josepablovr/Cable-Cam/docs/Assembly_Instructions.pdf

## Omar Gabriel Fuentes Aguilar Victor Vargas Chacon

## Juan Pablo Jimenez Anderson

Adrian Ernesto Orozco Rivera | 2017158313
| 2018099431
| 2018131797
| 2015158616
Jose Pablo Vasquez Rojas | 2019204801

## MT-8003 Manufacturing Systems

# Students:

Professor: Eng. Jaime Mora Meléndez M.Sc.

# Academic Area of Mechatronic Engineering

# Final Project: Assembly Instructions

# I Semester

2022

Machine Translated by Google

Second part of the framework

Ultrasonic sensor

Toothed pulley | 5
| 4

Assembly process:

4

Center pulley

Final assembly

1

6

5

1

Camera support | 2

Cabinet

7

Bearing support | 2
Support pulleys | 3

Parts List

Spreader bars | 3

First, the ultrasonic sensor support is assembled, 2 screws are used.

### M3x12 and its nuts. The same operation is repeated on the other part of the same

### M3x6, washers and nuts. Then the axle support is placed with 3 screws

### It should be assembled as follows:

## 1. Ultrasonic sensor

Assembly process:

### Index of instructions and sections

structure.

### 4 M3x12 screws with their respective nuts must be used. This process must be repeated in

### 3. Camera support

### Now the camera support is going to be assembled, for this 2 screws are used

### Bearing support

the other of the frame plates.

### Next, the bearing support is assembled, in this case they must

2.

M3x70, with washers and nuts and the 1¼-inch screw.
Note: The screw head is inserted all the way into the printed support.

### greater rigidity. To do this, use 4 M3x70 screws with their respective nuts and

### 5. Support pulleys

### Now the support pulleys will be placed, these use sleeves as

### The spreader bars are then placed on the structure, these provide it

washers.

### 4. Spreader bars

### spacers, use 2 of these sleeves, the pulley, 1 bearing and a steel shaft for

this part of the assembly. This step is repeated on the other side of the structure.

Center pulley

of plastic welding between the pulley and the shaft notches for optimal performance.

To mount the central pulley, the remaining 2 sleeves, the pulley and the shaft are used.

6.

Note: When attaching the pulley, an epoxy resin glue or glue must be used.

### 7. Second part of the frame Next, the

second part of the frame is assembled.

nut that must be inserted into the pulley slot.

9.

The last step is to place the electronic part cabinet. To do this use the 4

M3x20 screws, together with the spacers and nuts as shown in the figure.

In this step you will place the toothed pulley, for this use an M3x12 screw and a

Cabinet

### 8. Toothed pulley

This is what the final assembly should look like.

### After this step the engine must be placed, the 20T-2GT toothed pulley together with its

### 10. Final assembly

timing band.

## Parts List
