josepablovr/Cable-Cam/docs/wiring_diagram.pdf

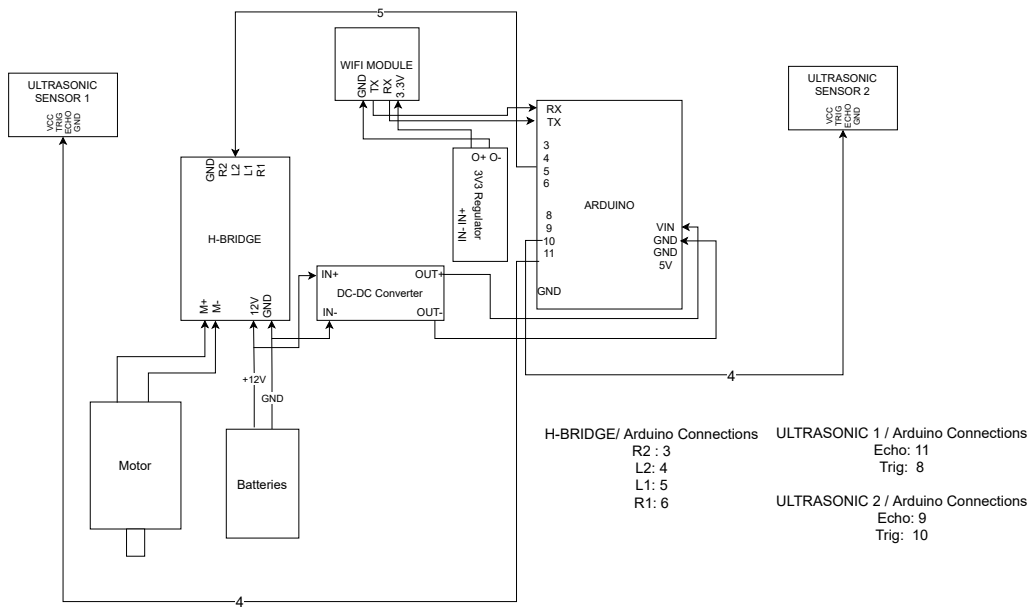
[picture p4: page 1]
H-BRIDGE; GND; OUT+; OUT-; ARDUINO; VIN GND GND 5V; ULTRASONIC; Batteries; Motor; Echo: 11 Trig: 8; Echo: 9 Trig: 10

WIFI MODULE GND TXRX 3.3V

SENSOR 1 VCC TRIG ECHO GND

SENSOR 2 VCC TRIG ECHO GND

3V3 Regulator IN- IN+

DC-DC Converter

H-BRIDGE/ Arduino Connections

ULTRASONIC 1 / Arduino Connections

ULTRASONIC 2 / Arduino Connections
