josepablovr/Cable-Cam/docs/Blueprints.pdf

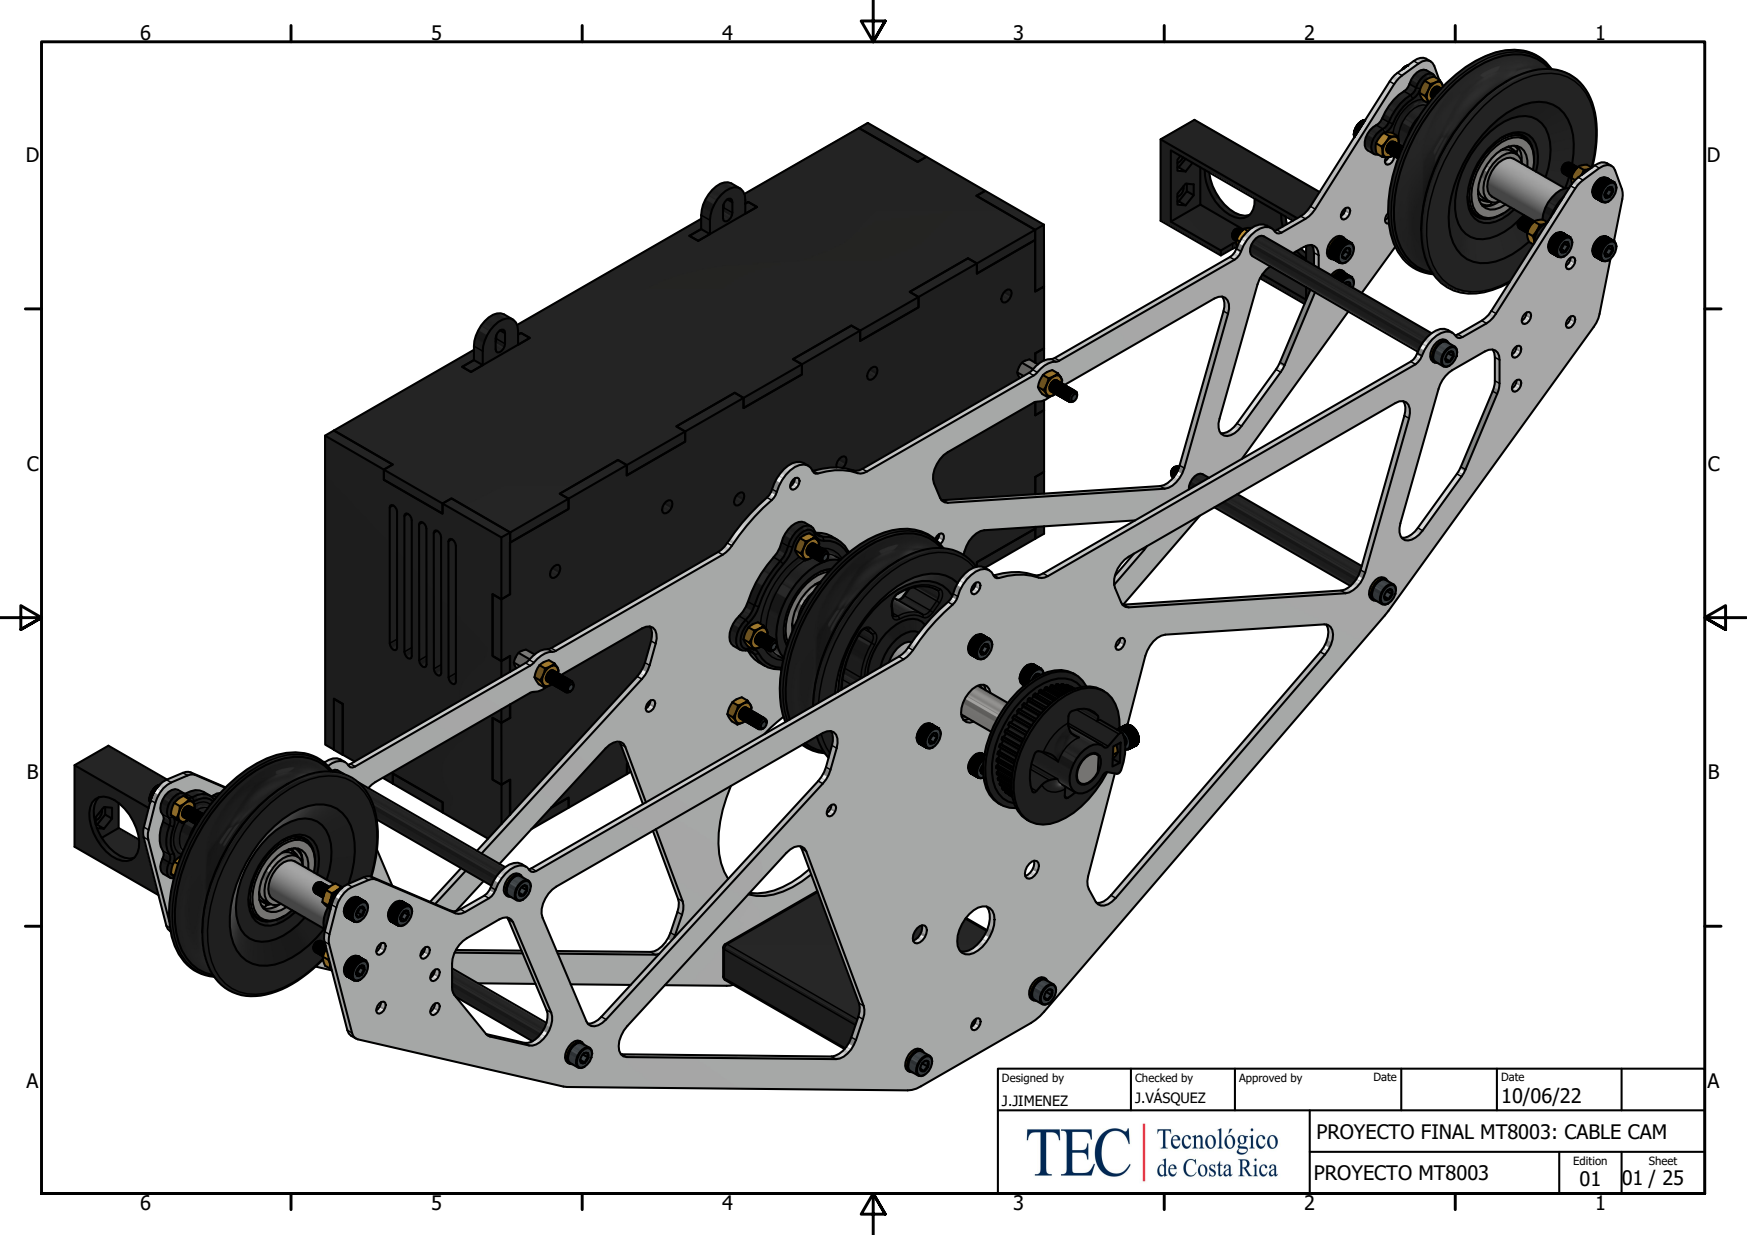
[picture p5: page 1]
PROYECTO MT8003; J.JIMENEZ; J.VÈSQUEZ; Designed by; Checked by; Approved by; Date; Edition; Sheet

PROYECTO FINAL MT8003: CABLE CAM

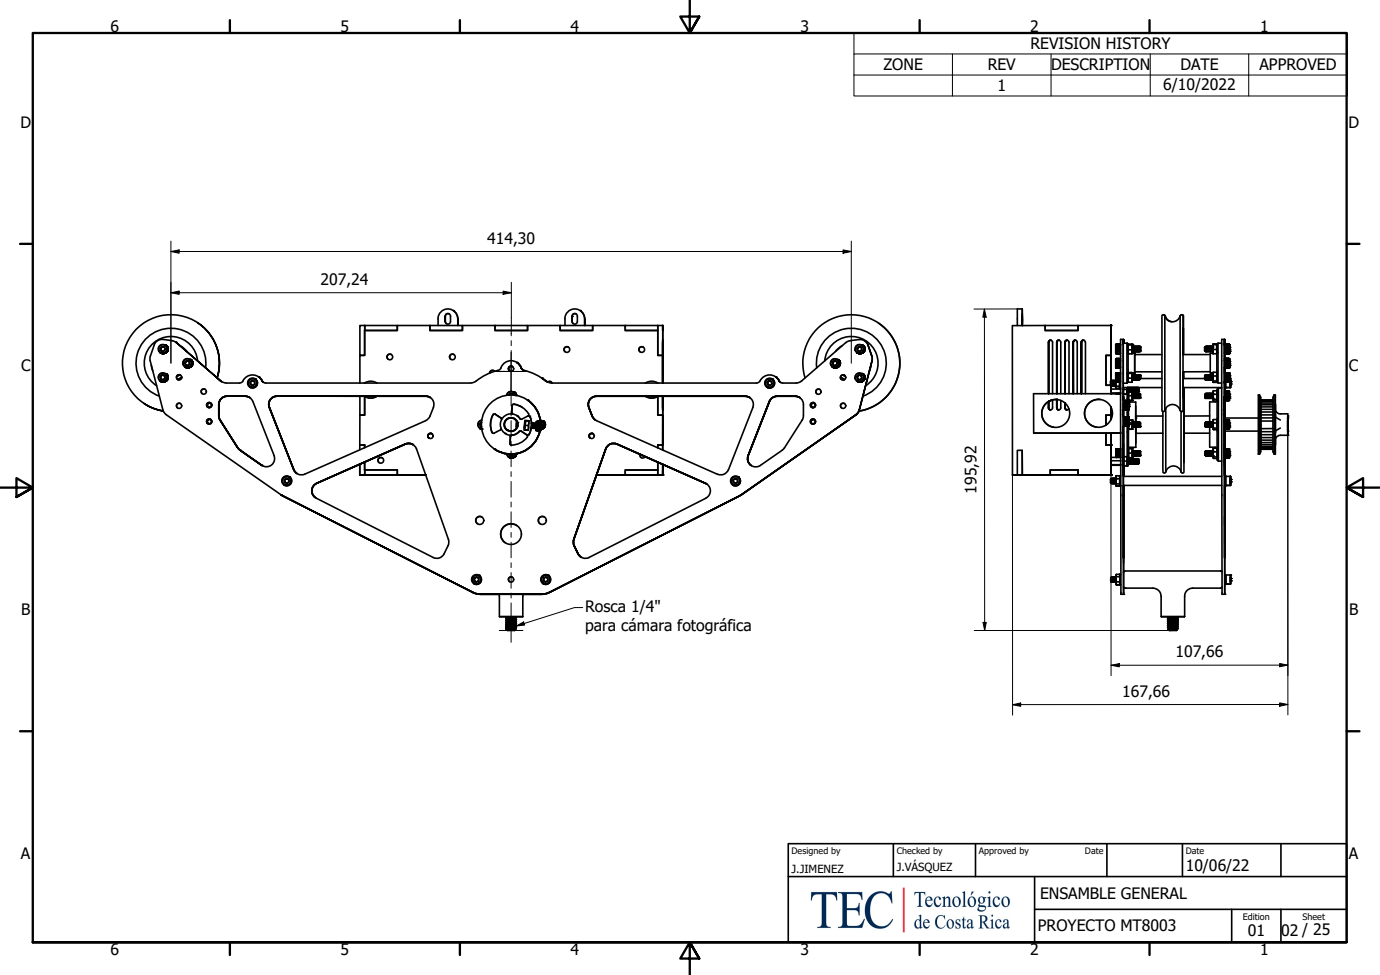
[picture p6: page 2]
J.JIMENEZ; J.VÈSQUEZ; Designed by; Checked by; Approved by; Date; REVISION HISTORY; ZONE; REV; DESCRIPTION; DATE; APPROVED; ENSAMBLE GENERAL

Rosca 1/4"
para cimara fotogrifica

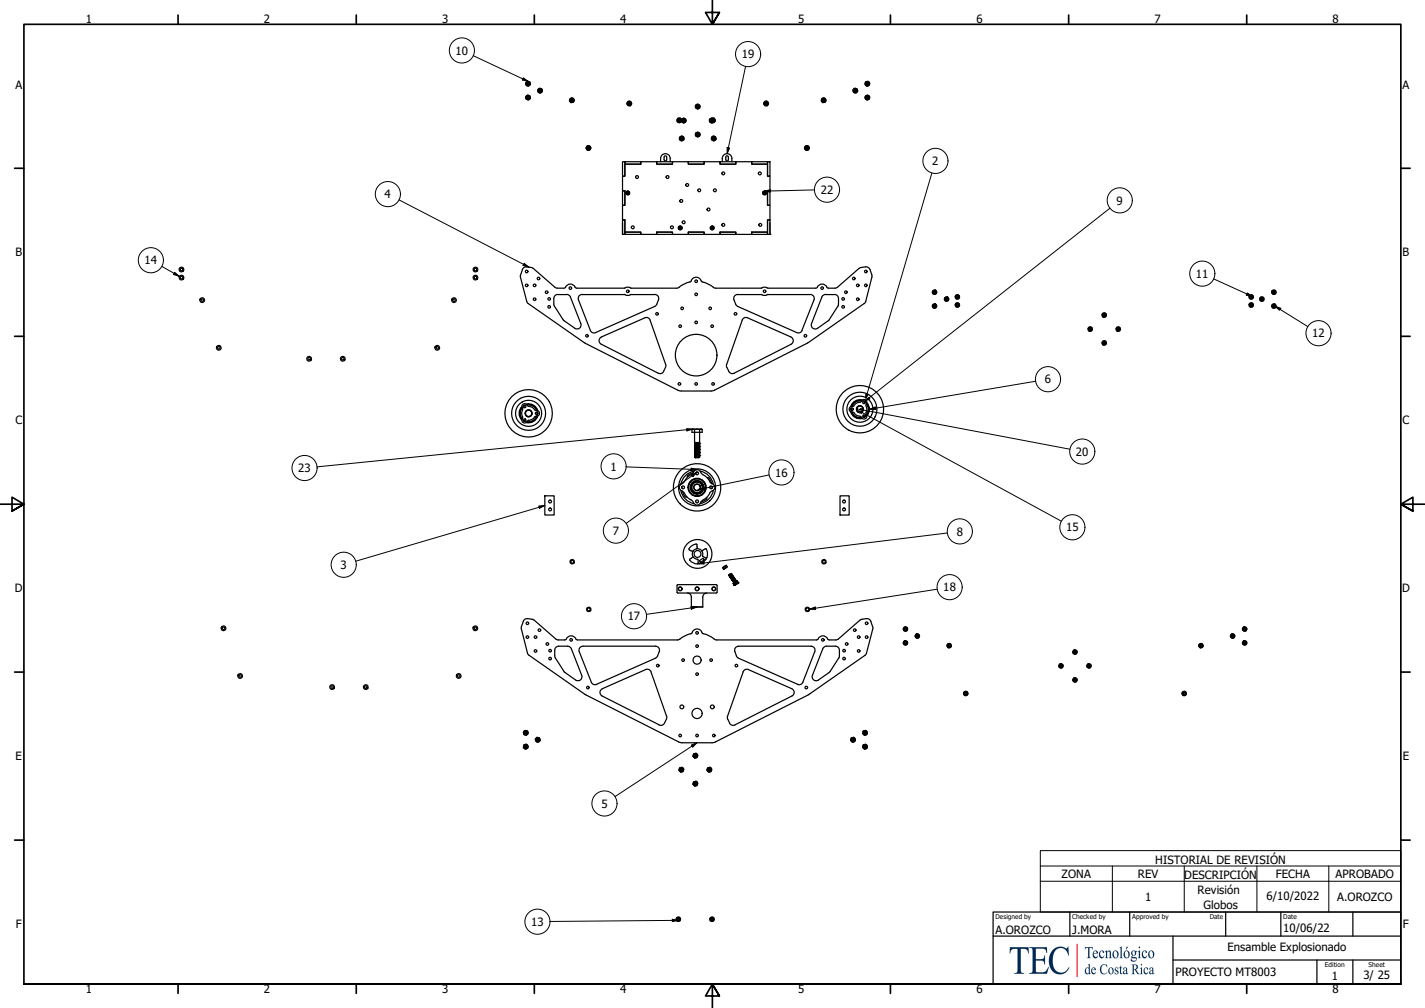
[picture p7: page 3]
Ensamble Explosionado; A.OROZCO; J.MORA; Designed by; Checked by; Approved by; Date; ZONA; REV; DESCRIPCIÓN; FECHA; APROBADO; Revisión Globos

HISTORIAL DE REVISIÓN

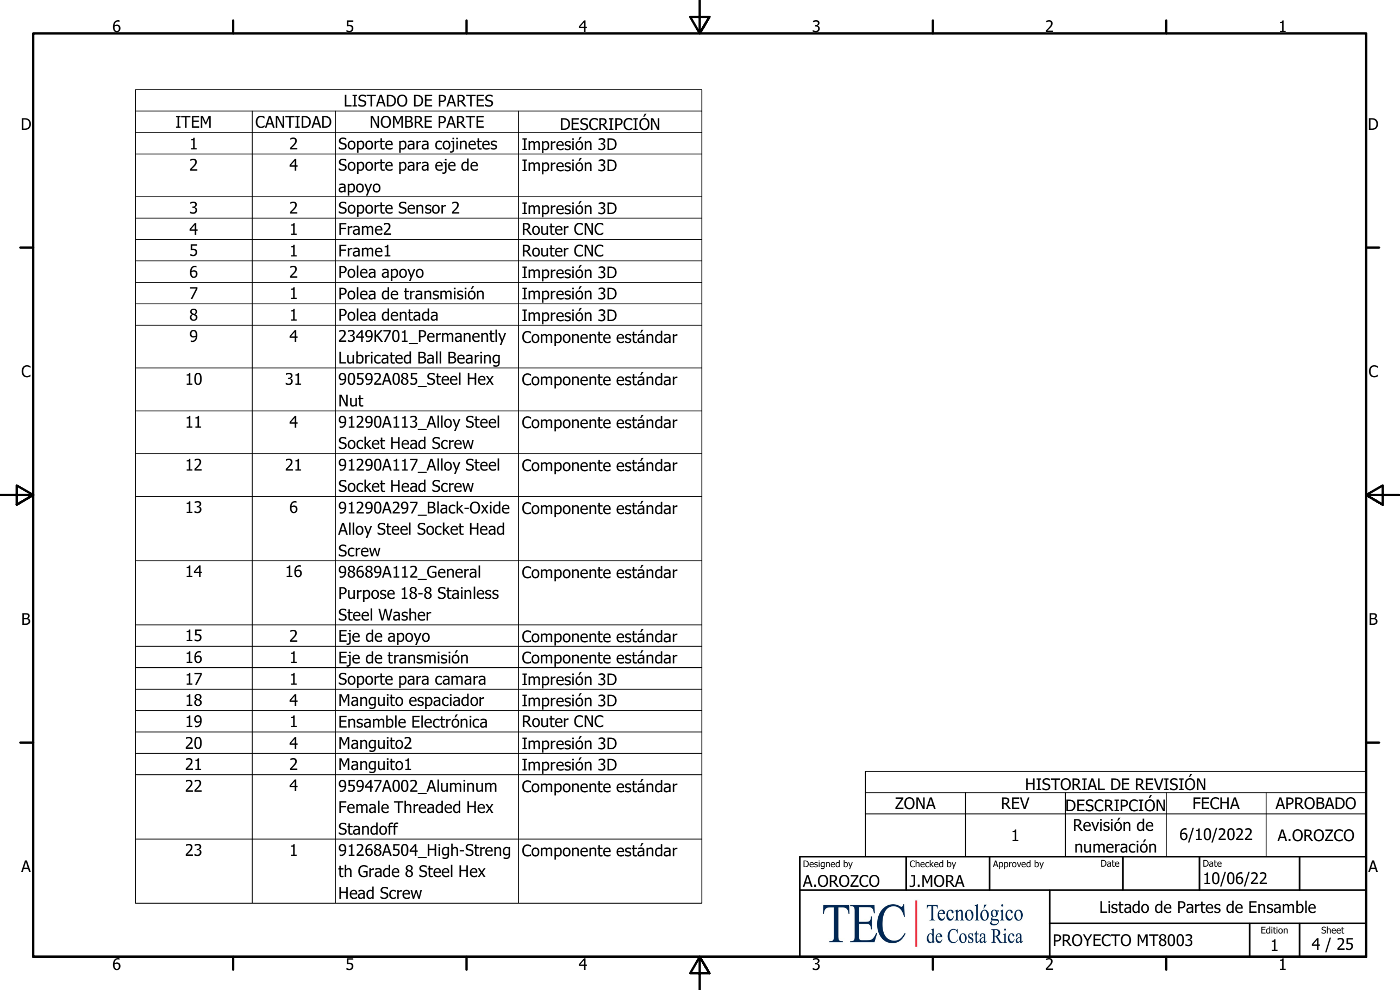
[picture p8: figure]
ole; tly; all B; _Allo; Bla; Allo; nle; ble; Ele; _Alu; ale
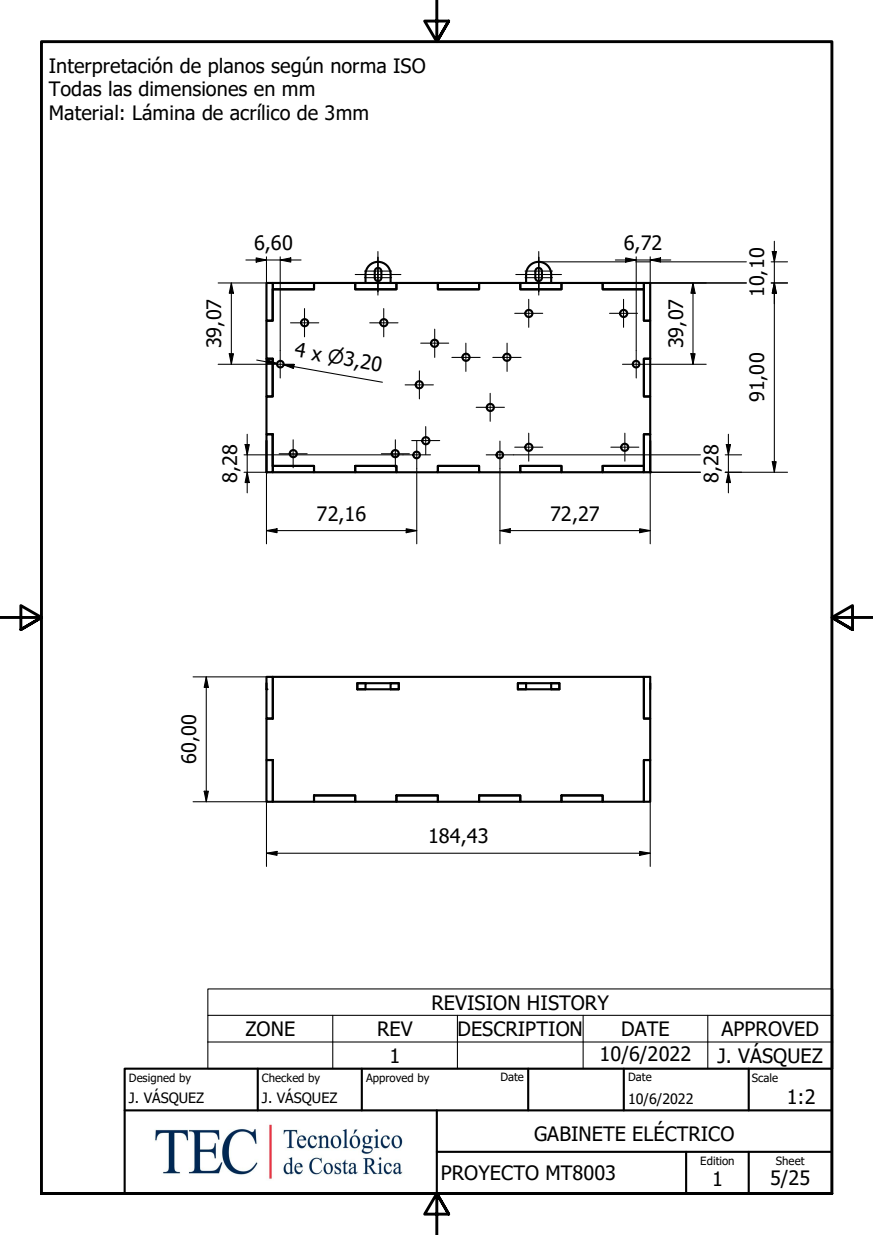
[picture p9: page 5]
GABINETE ELeCTRICO; J. VÈSQUEZ; Designed by; Checked by; Approved by; Date; Scale; REVISION HISTORY; ZONE; REV; DESCRIPTION; DATE; APPROVED

Interpretaciyn de planos seg~n norma ISO
Todas las dimensiones en mm
Material: Limina de acrtlico de 3mm

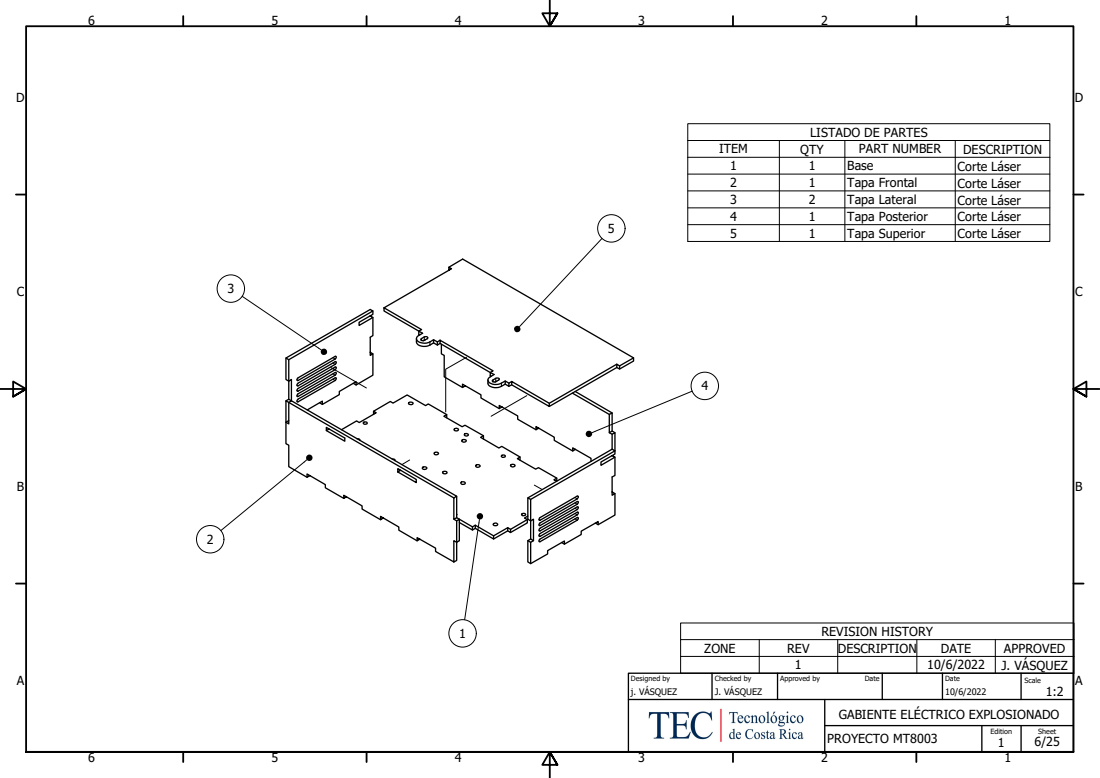
[picture p10: page 6]
ITEM; QTY; PART NUMBER; DESCRIPTION; Base; Corte Liser; Tapa Frontal; Tapa Lateral; Tapa Posterior; Tapa Superior; j. VÈSQUEZ; J. VÈSQUEZ; Designed by; Checked by; Approved by; Date; Scale; REVISION HISTORY; ZONE; REV; DATE; APPROVED

LISTADO DE PARTES

GABIENTE ELeCTRICO EXPLOSIONADO

A

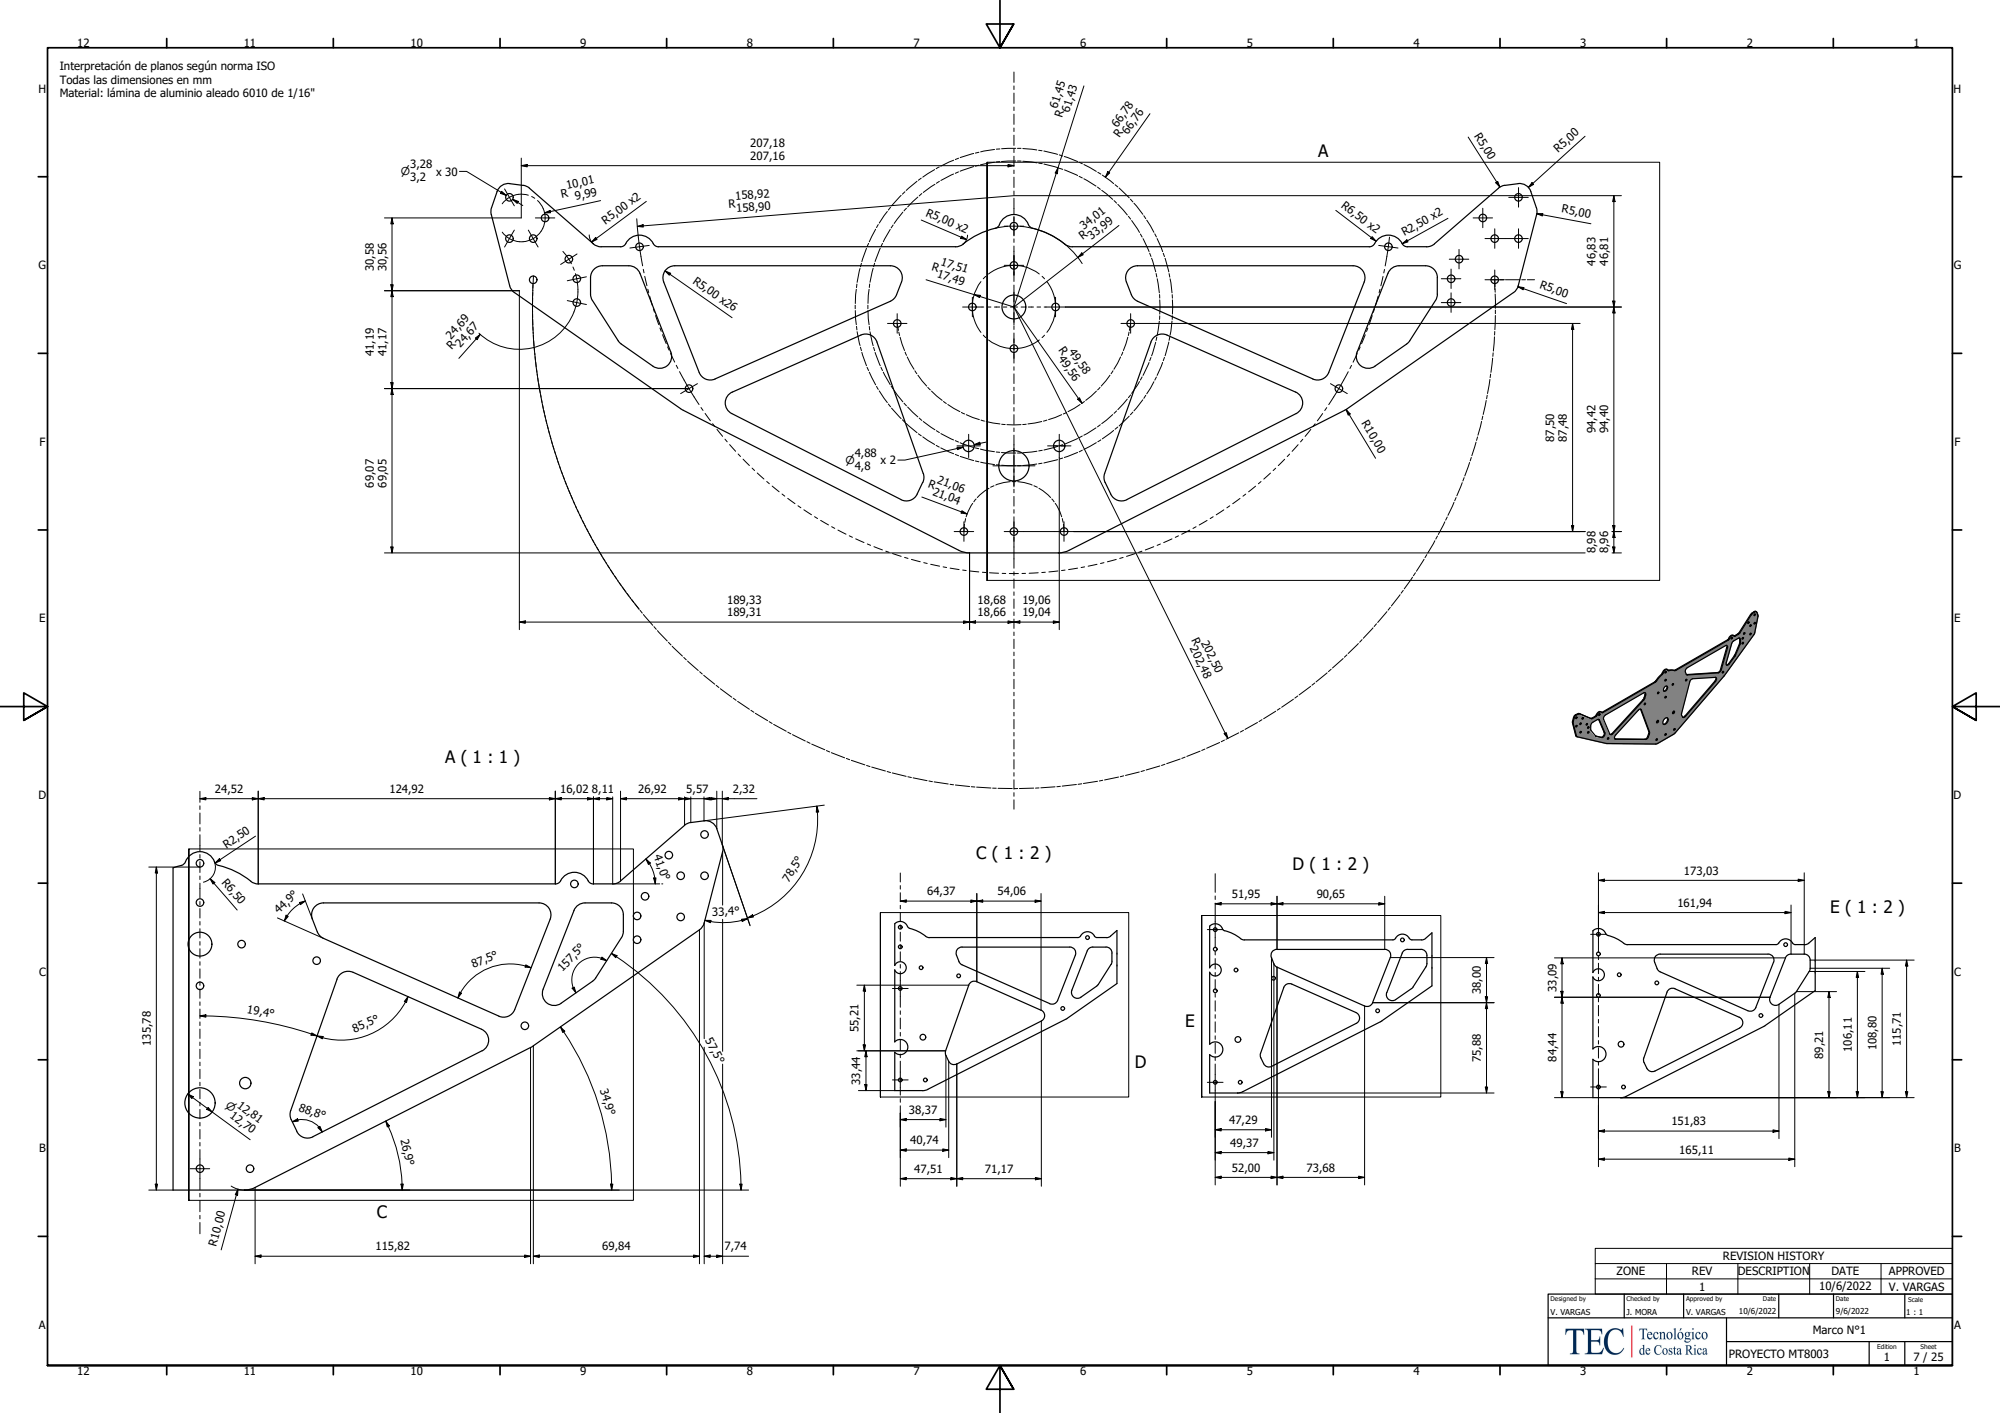
[picture p11: page 7]
Marco N°1; V. VARGAS; J. MORA; Designed by; Checked by; Approved by; Date; Scale; REVISION HISTORY; ZONE; REV; DESCRIPTION; DATE; APPROVED

Interpretaciyn de planos seg~n norma ISO
Todas las dimensiones en mm
Material: limina de aluminio aleado 6010 de 1/16"

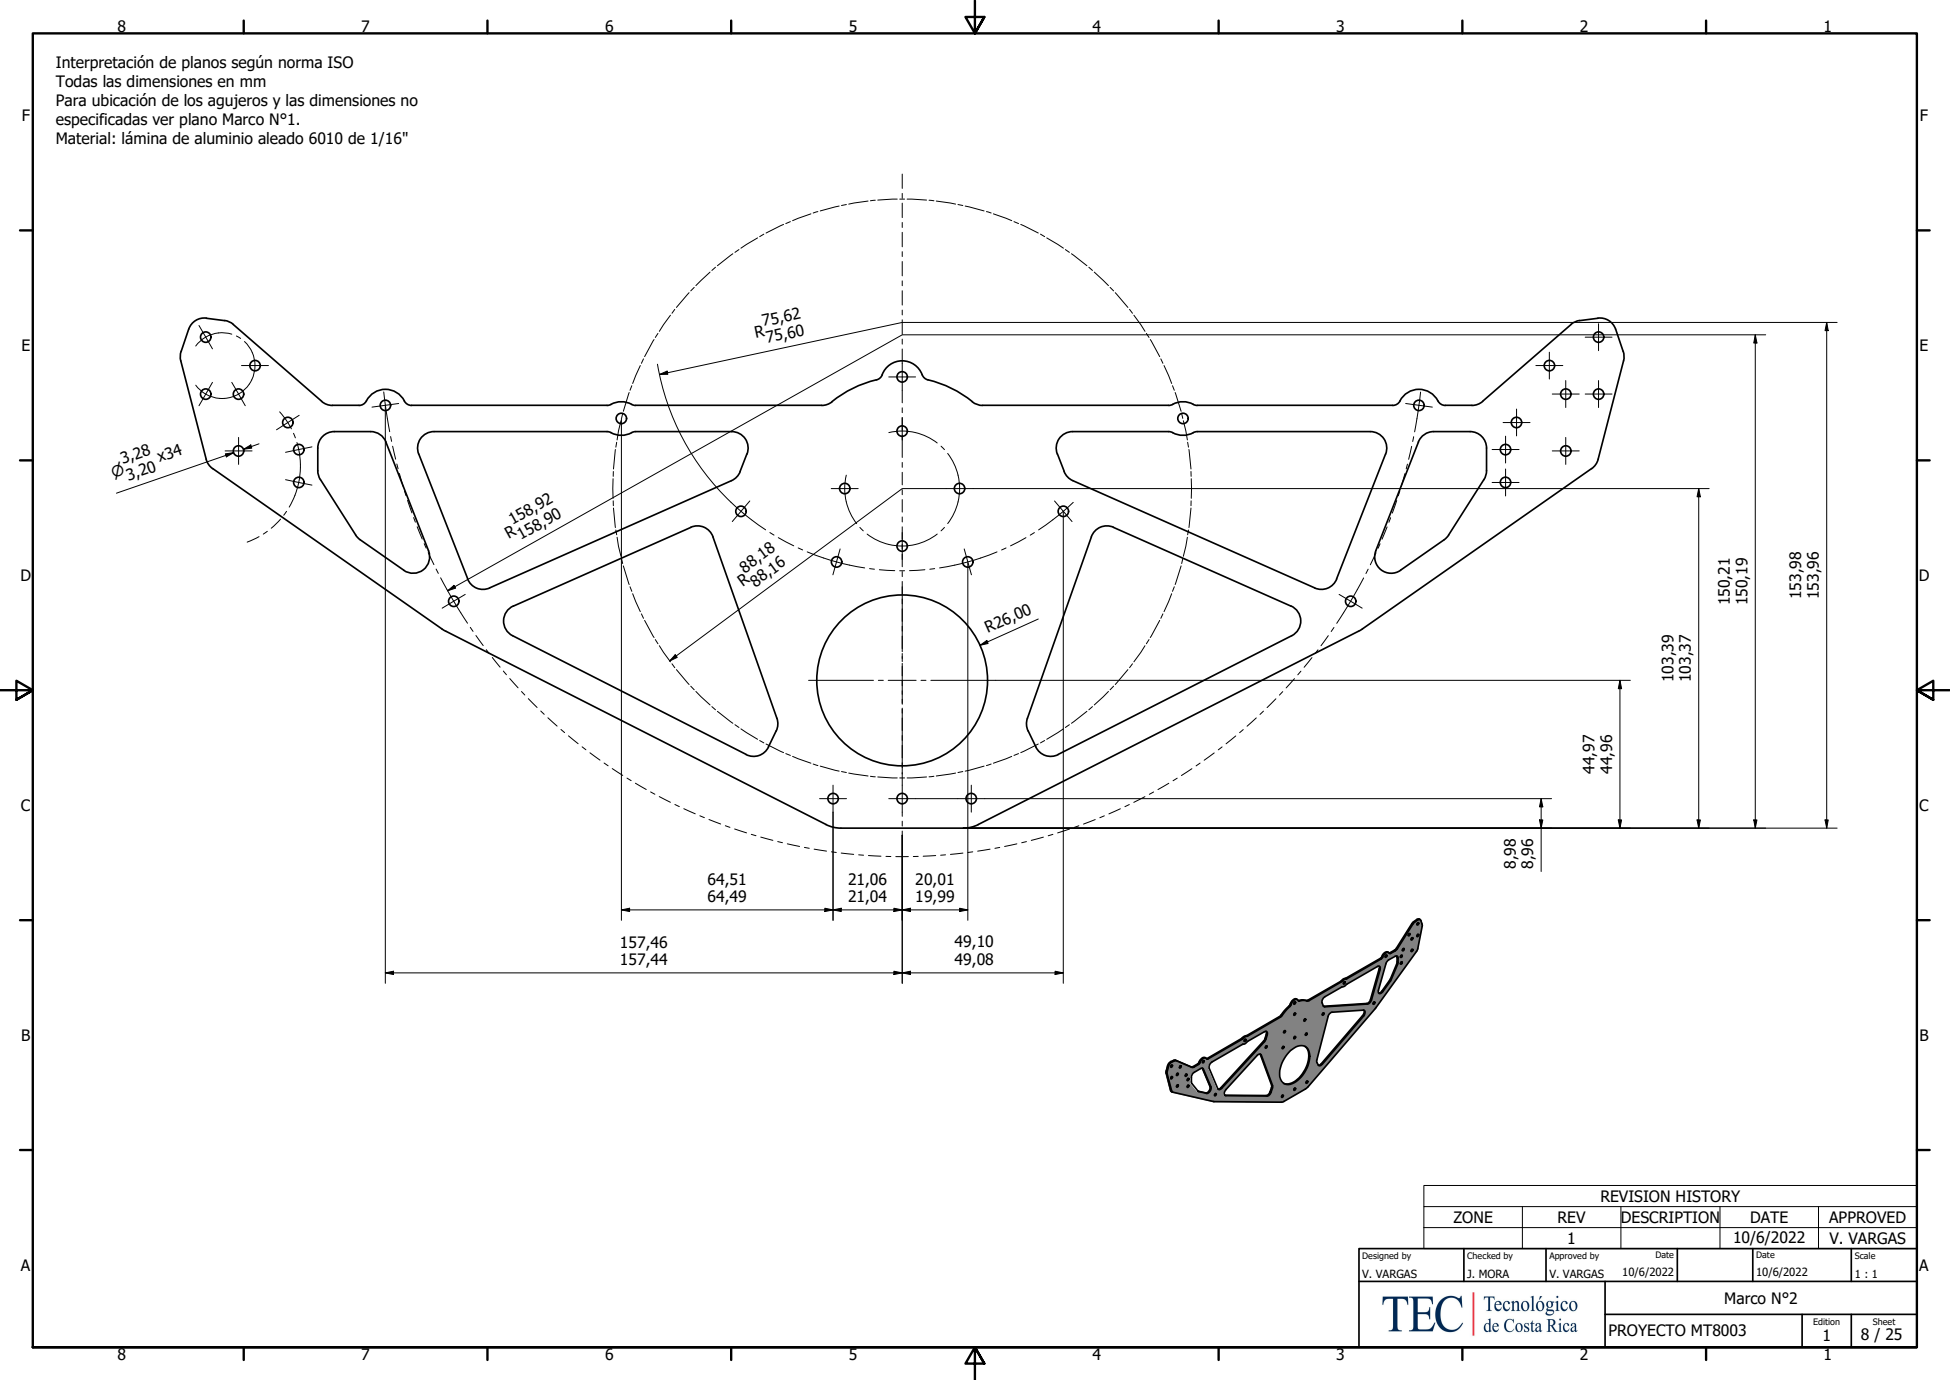
[picture p12: page 8]
Marco N°2; V. VARGAS; J. MORA; Designed by; Checked by; Approved by; Date; Scale; REVISION HISTORY; ZONE; REV; DESCRIPTION; DATE; APPROVED

Interpretaciyn de planos seg~n norma ISO
Todas las dimensiones en mm
Para ubicaciyn de los agujeros y las dimensiones no
especificadas ver plano Marco N°1.
Material: limina de aluminio aleado 6010 de 1/16"

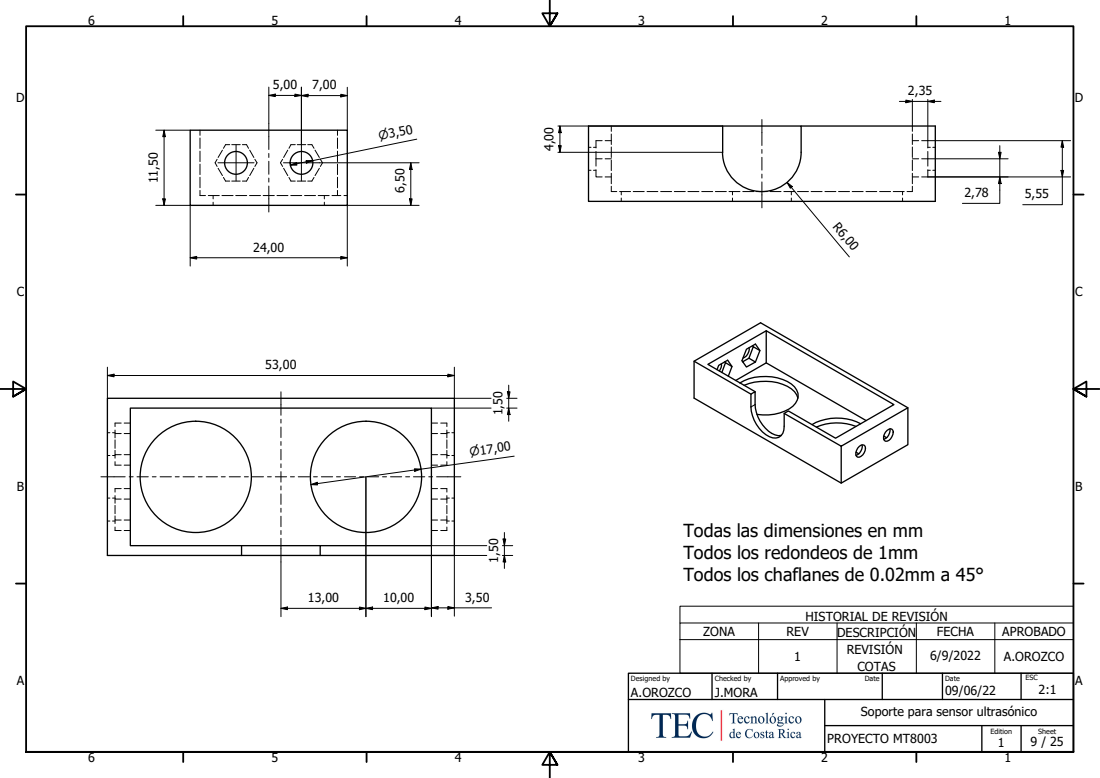
[picture p13: page 9]
A.OROZCO; J.MORA; Designed by; Checked by; Approved by; Date; ZONA; REV; DESCRIPCIÓN; FECHA; APROBADO; REVISIÓN; COTAS; ESC

Todas las dimensiones en mm
Todos los redondeos de 1mm
Todos los chaflanes de 0.02mm a 45°

HISTORIAL DE REVISIÓN

Soporte para sensor ultrasónico

A

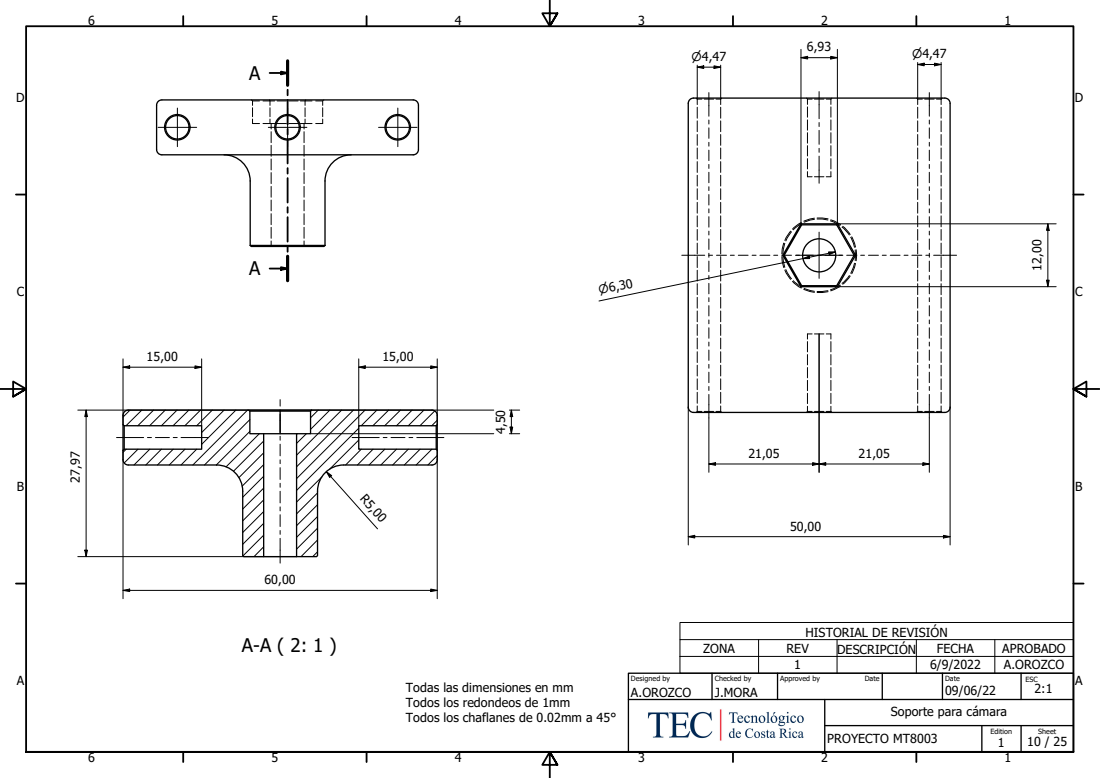
[picture p14: page 10]
A.OROZCO; J.MORA; Designed by; Checked by; Approved by; Date; ZONA; REV; DESCRIPCIÓN; FECHA; APROBADO; ESC

HISTORIAL DE REVISIÓN

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

Soporte para cámara

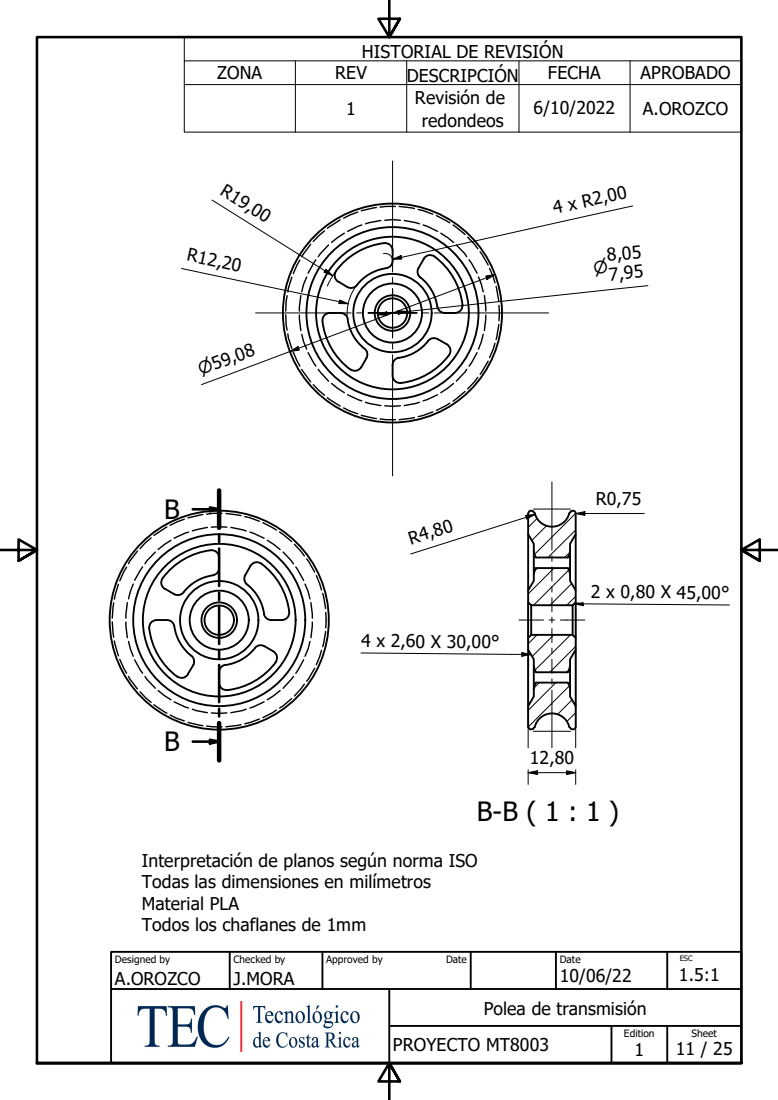
[picture p15: page 11]
A.OROZCO; J.MORA; Designed by; Checked by; Approved by; Date; ZONA; REV; DESCRIPCIÓN; FECHA; APROBADO; Revisión de redondeos; ESC

HISTORIAL DE REVISIÓN

Interpretación de planos según norma ISO
Todas las dimensiones en milímetros
Material PLA
Todos los chaflanes de 1mm

Polea de transmisión

A-A ( 3 : 1 )

A

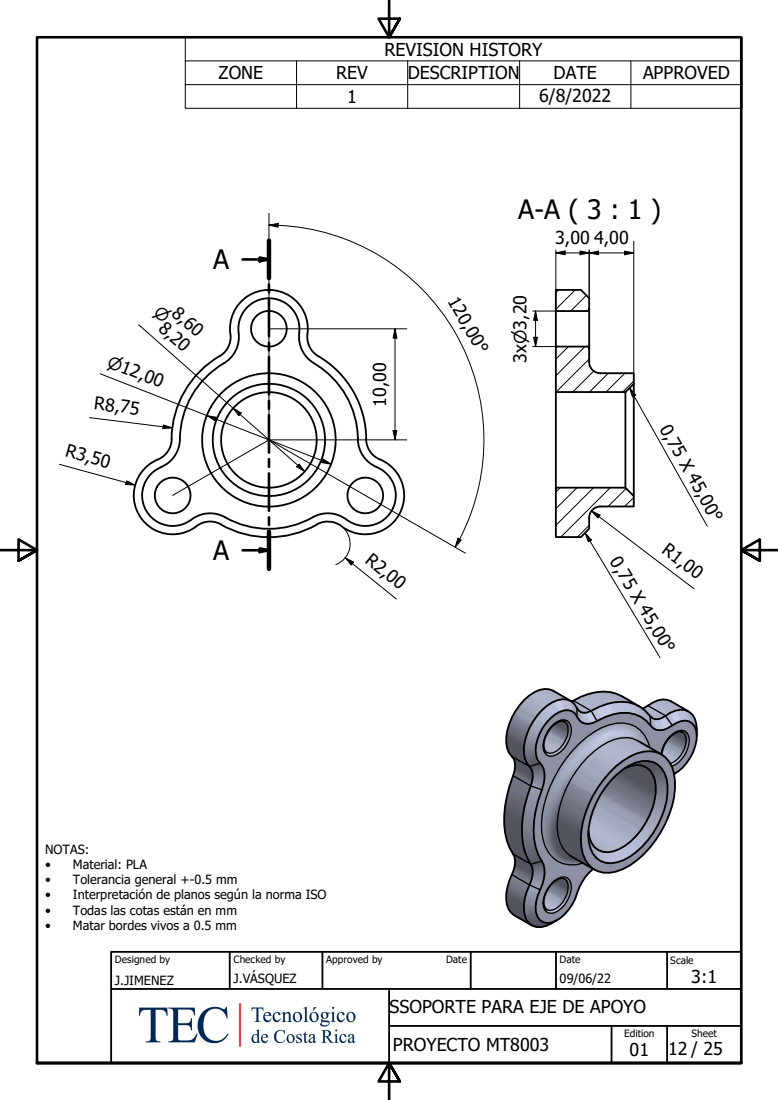
[picture p16: page 12]
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

NOTAS:
• Material: PLA
• Tolerancia general +-0.5 mm
• Interpretaciyn de planos seg~n la norma ISO
• Todas las cotas estin en mm
• Matar bordes vivos a 0.5 mm

SSOPORTE PARA EJE DE APOYO

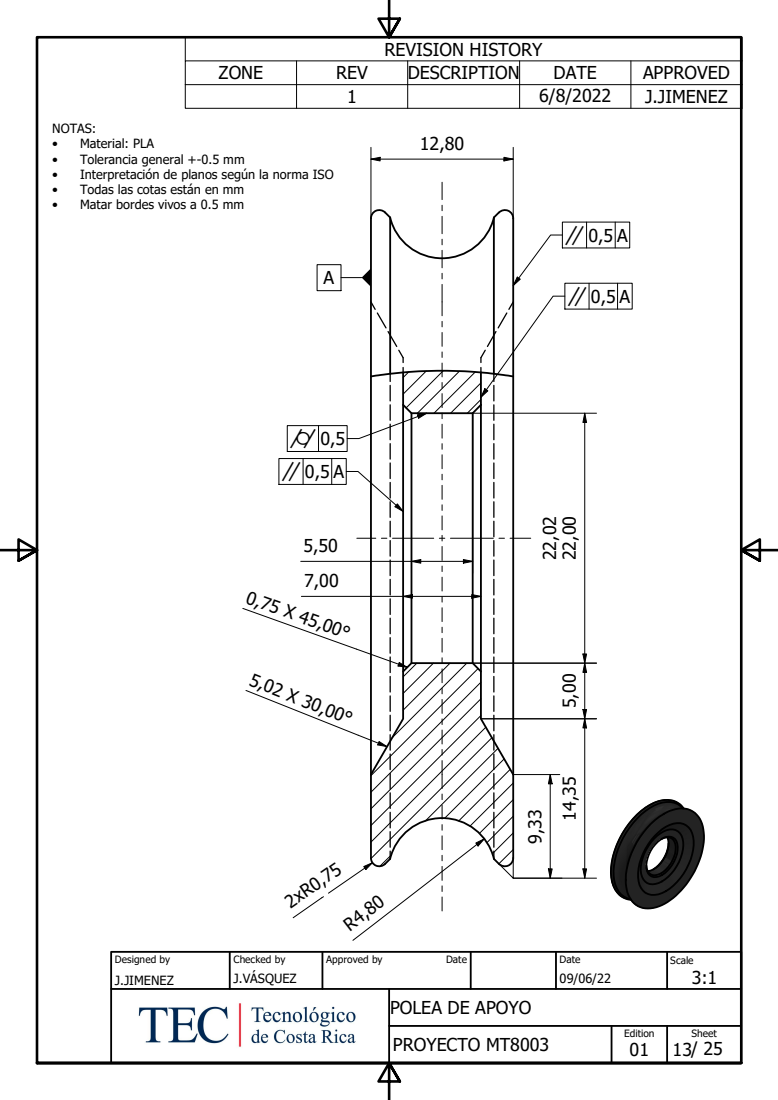
[picture p17: page 13]
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

POLEA DE APOYO

A-A ( 2 : 1 )

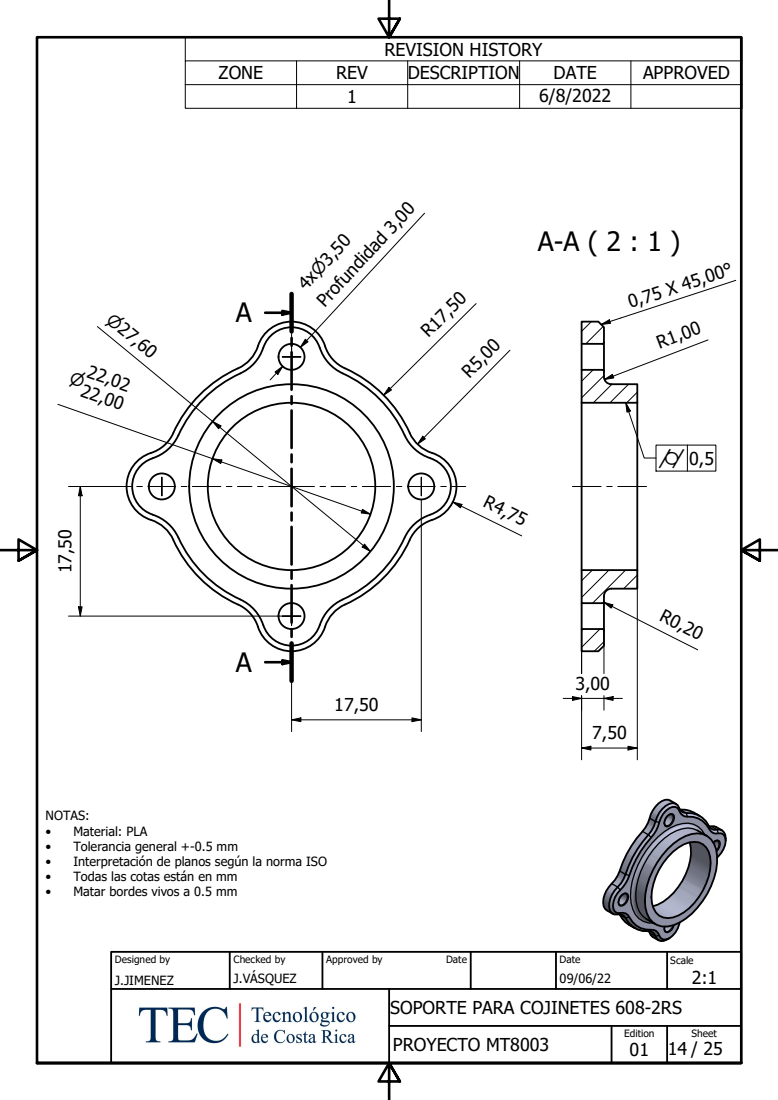
[picture p18: page 14]
J.JIMENEZ; J.VÈSQUEZ; Designed by; Checked by; Approved by; Date; Scale; REVISION HISTORY; ZONE; REV; DESCRIPTION; DATE; APPROVED; Profundidad 3,00

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

SOPORTE PARA COJINETES 608-2RS

A-A ( 2 : 1 )

A

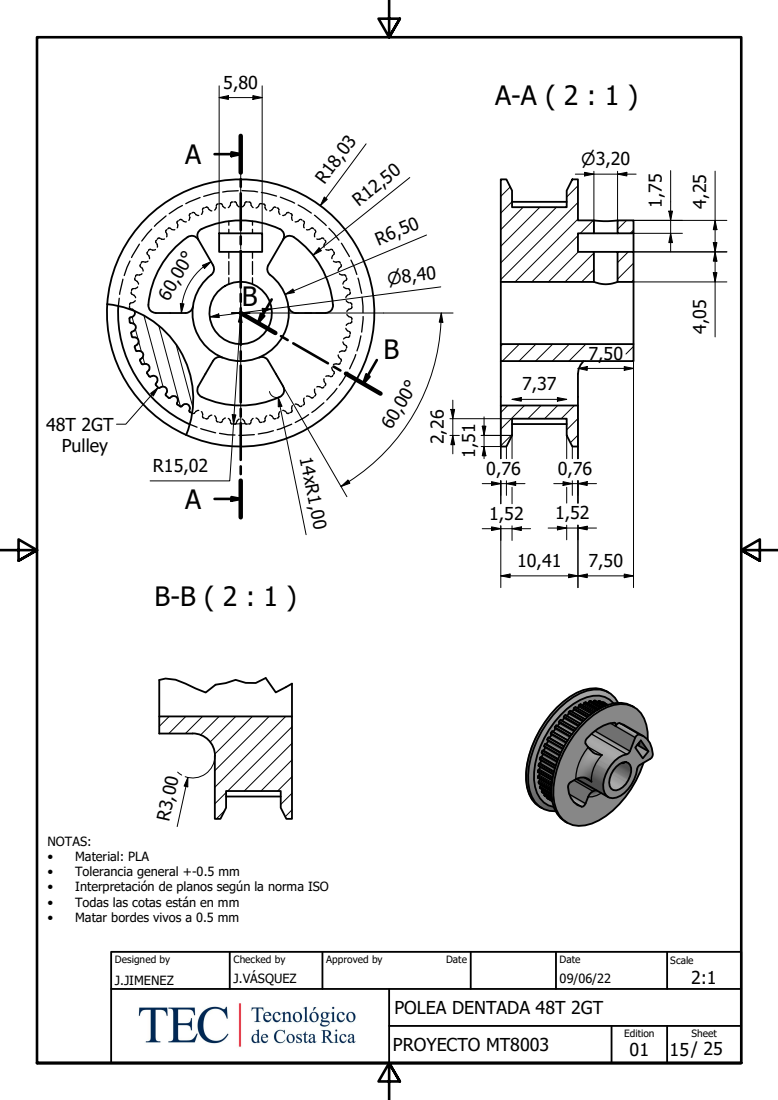
[picture p19: page 15]
J.JIMENEZ; J.VÈSQUEZ; Designed by; Checked by; Approved by; Date; Scale; 48T 2GT Pulley; POLEA DENTADA 48T 2GT

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

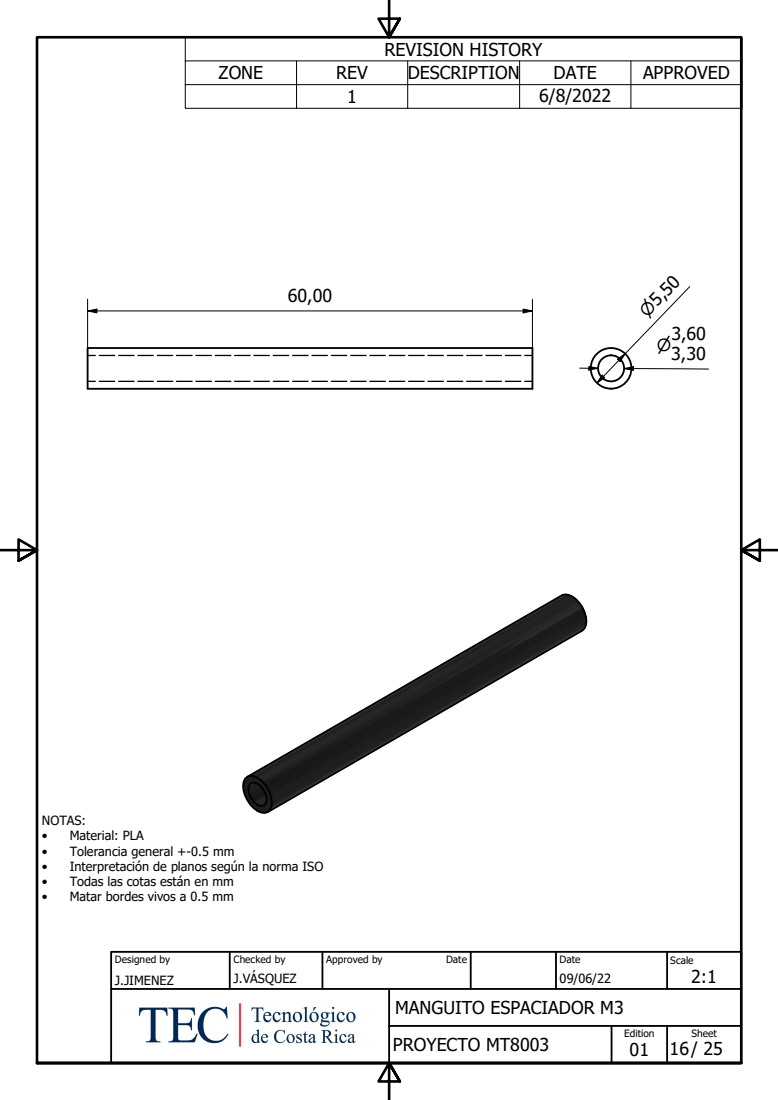
[picture p20: page 16]
J.JIMENEZ; J.VÈSQUEZ; Designed by; Checked by; Approved by; Date; Scale; REVISION HISTORY; ZONE; REV; DESCRIPTION; DATE; APPROVED; MANGUITO ESPACIADOR M3

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

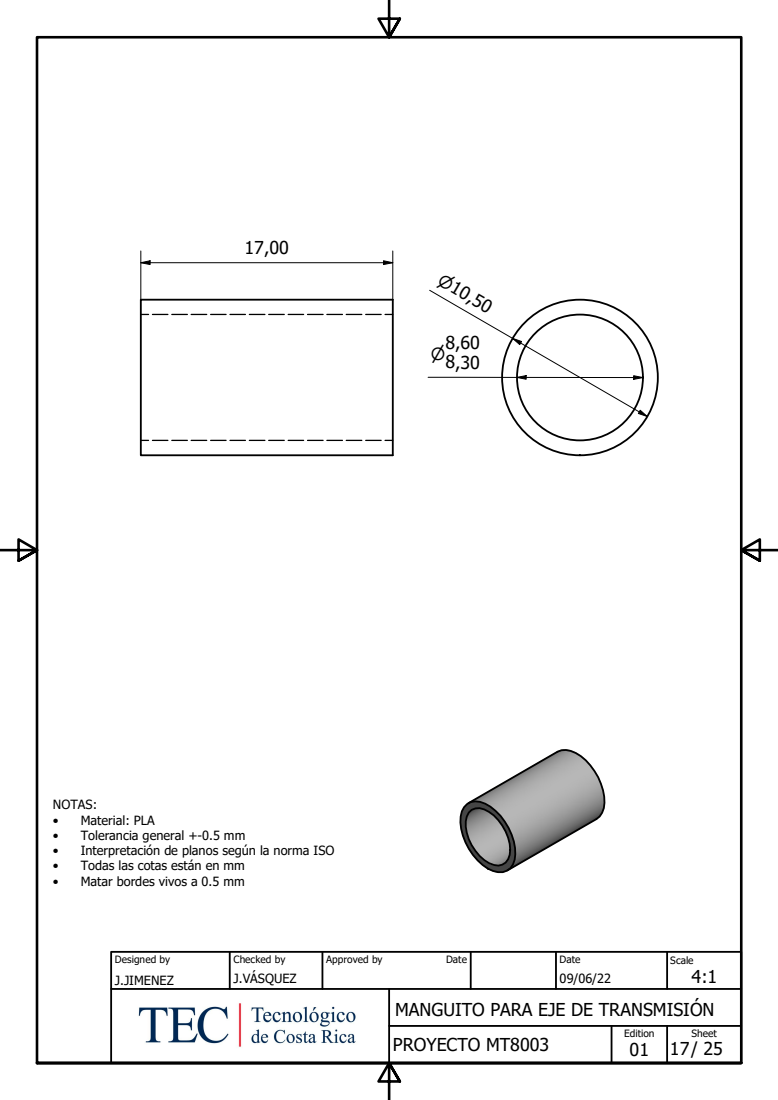
[picture p21: page 17]
J.JIMENEZ; J.VÈSQUEZ; Designed by; Checked by; Approved by; Date; Scale

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

MANGUITO PARA EJE DE TRANSMISIÏN

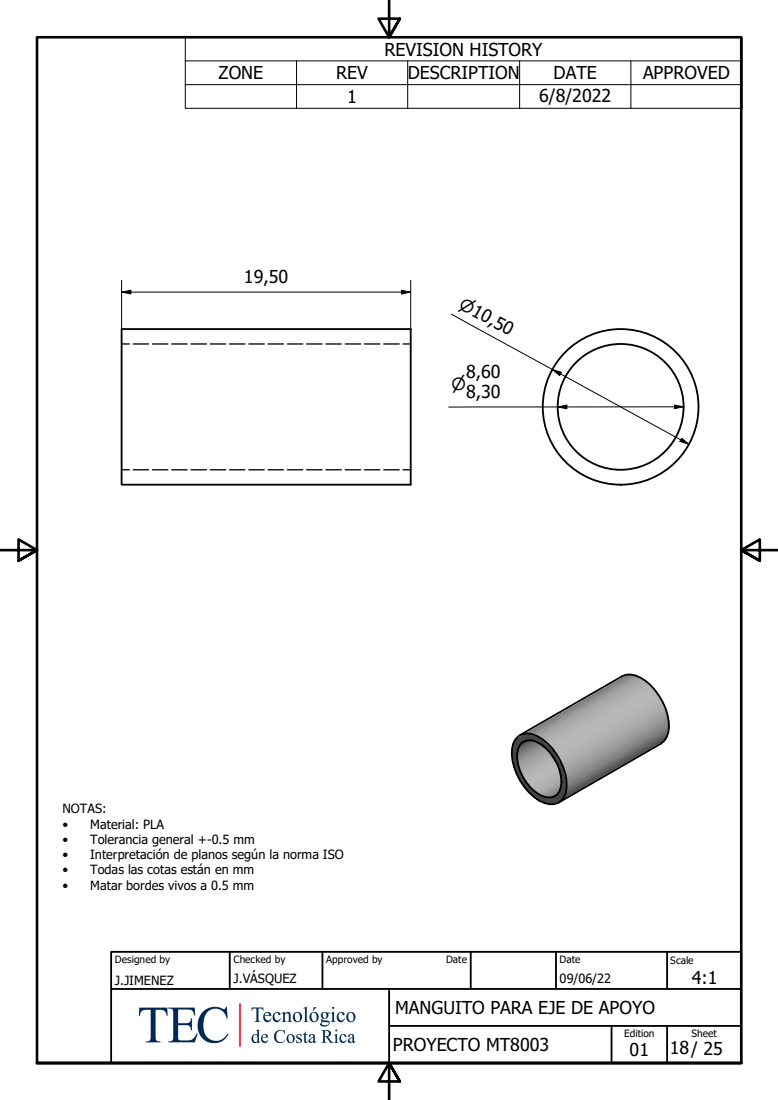
[picture p22: page 18]
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

MANGUITO PARA EJE DE APOYO

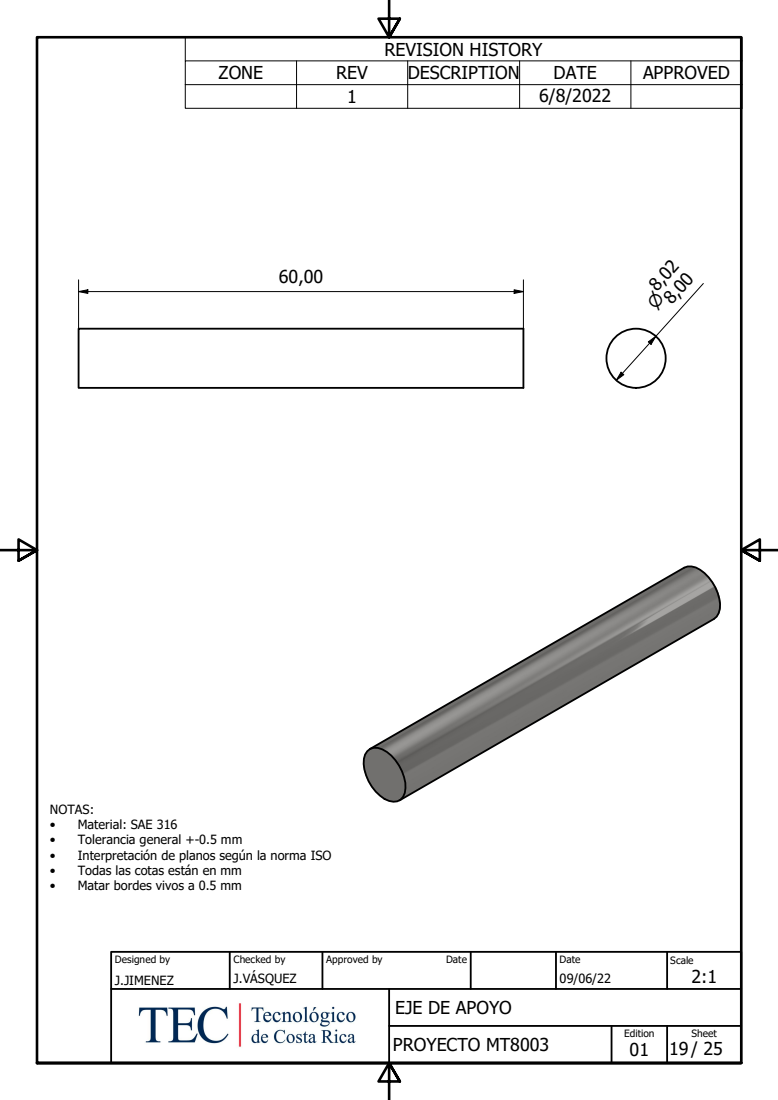
[picture p23: page 19]
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

NOTAS:
• Material: SAE 316
• Tolerancia general +-0.5 mm
• Interpretaciyn de planos seg~n la norma ISO
• Todas las cotas estin en mm
• Matar bordes vivos a 0.5 mm

EJE DE APOYO

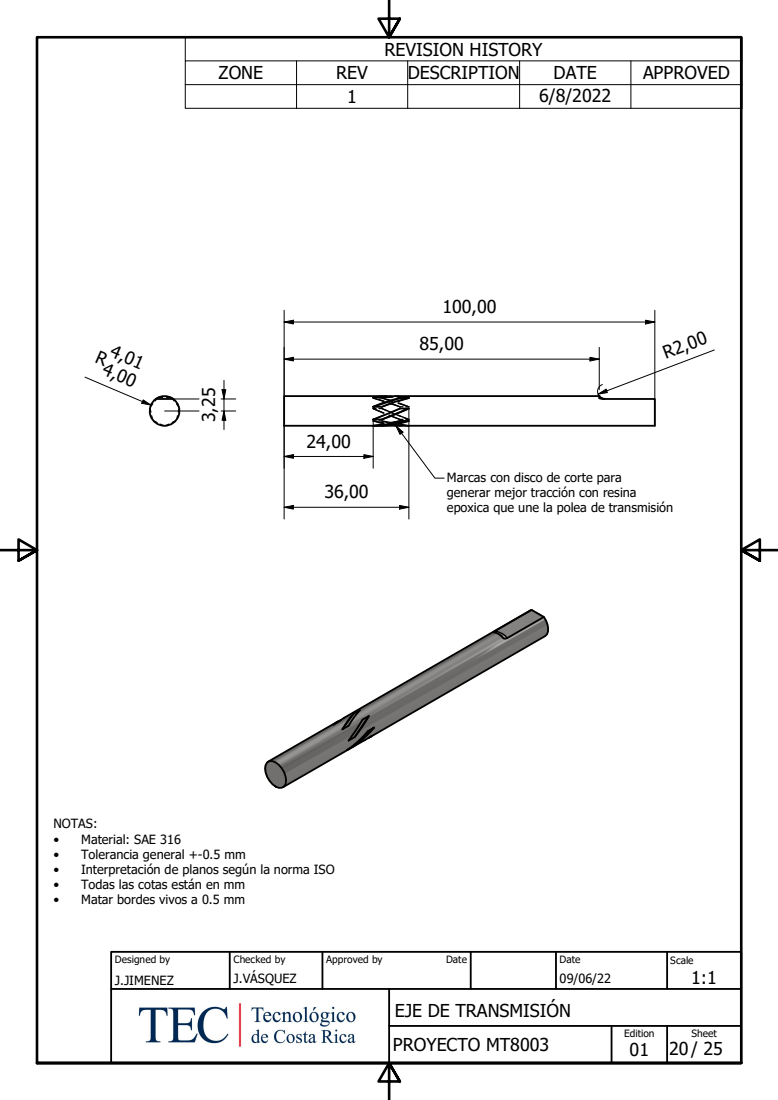
[picture p24: page 20]
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

Marcas con disco de corte para
generar mejor tracciyn con resina
epoxica que une la polea de transmisiyn

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

EJE DE TRANSMISIÏN

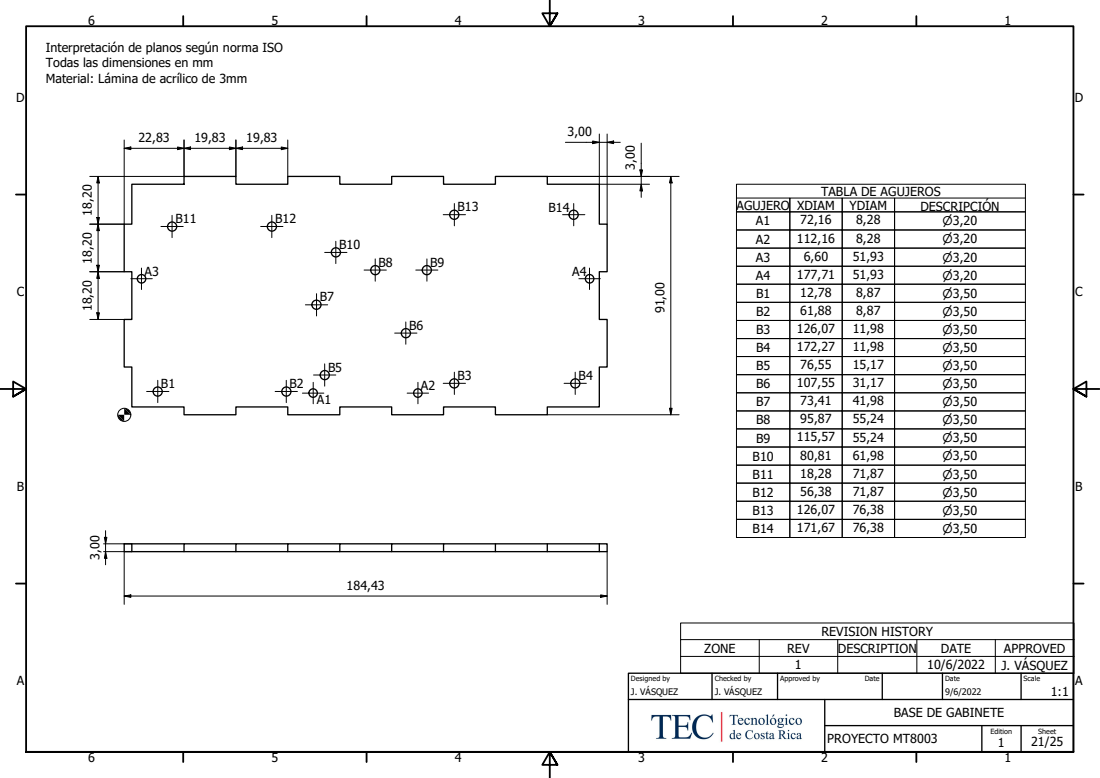
[picture p25: page 21]
J. VÈSQUEZ; Designed by; Checked by; Approved by; Date; Scale; AGUJERO XDIAM; YDIAM; DESCRIPCIÏN; REVISION HISTORY; ZONE; REV; DESCRIPTION; DATE; APPROVED

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

TABLA DE AGUJEROS

BASE DE GABINETE

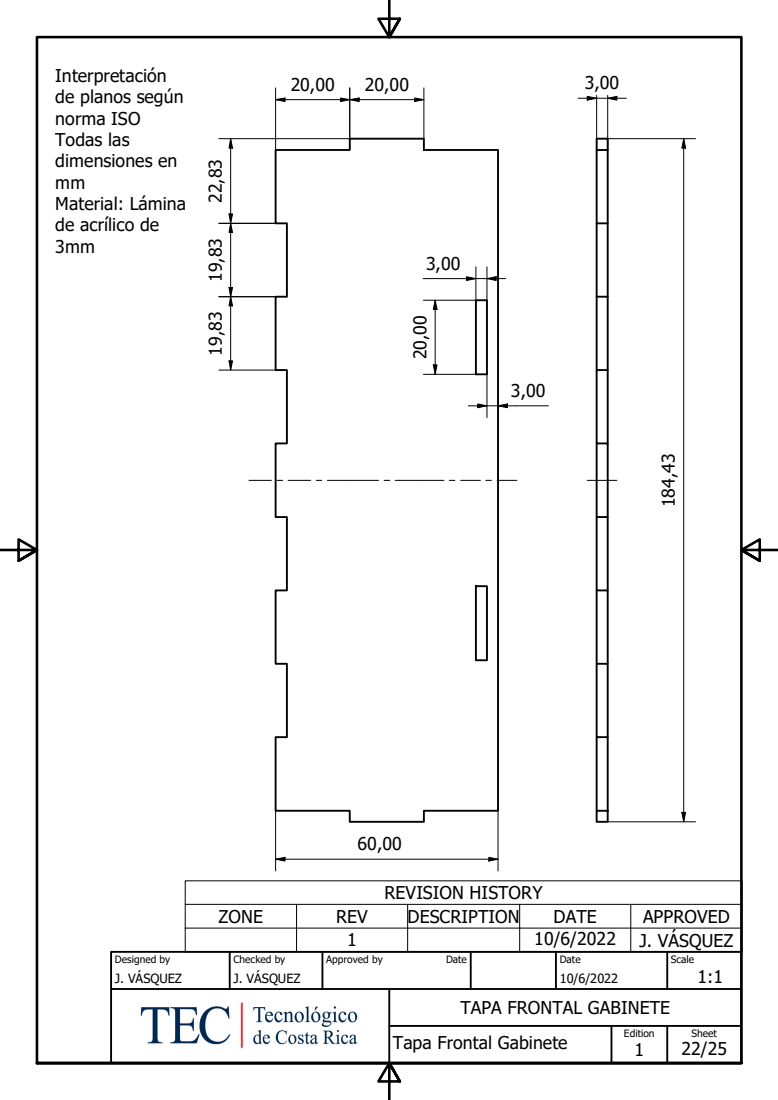
[picture p26: page 22]
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

Interpretaciyn
de planos seg~n
norma ISO
Todas las
dimensiones en
Material: Limina
de acrtlico de

TAPA FRONTAL GABINETE

Tapa Frontal Gabinete

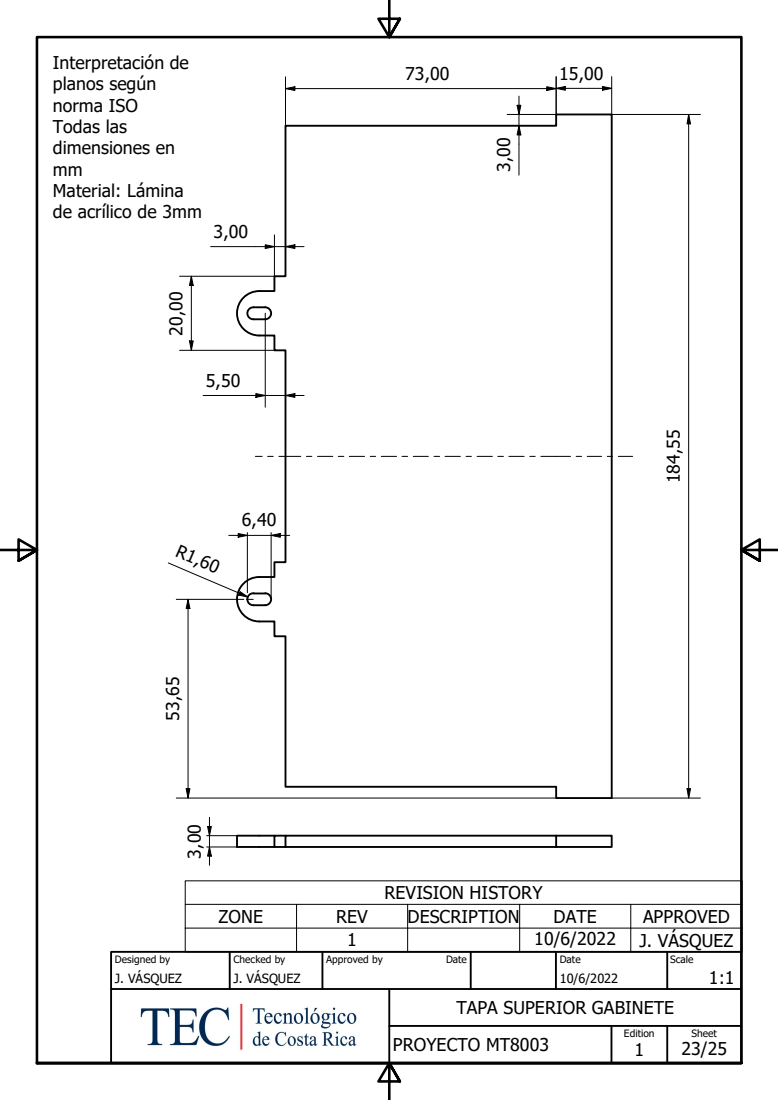
[picture p27: page 23]
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

Interpretaciyn de
planos seg~n
norma ISO
Todas las
dimensiones en
Material: Limina
de acrtlico de 3mm

TAPA SUPERIOR GABINETE
